KoichiShintani/FamiliesEyeDevice/Doc/FW設計.xlsx

Sheet: 機能リスト
機能一覧
 | 対象状態 | 発動条件 | 説明 | 備考
ビープ音 | 待機 | 遷移時 | 起動音 | ドミソド↑(CEGC↑)
 | 転倒 | 状態中 | 転倒音 | ドド↑ (CC↑)繰り返し 1秒毎
 | SOS | 状態中 | SOS音 | ド↑ラ (C↑A)繰り返し 20Hz
 | any | SOS押下中 | SOS SW押下 | ド↑ (C↑)(1秒毎に繰り返し)
 | 困ってる | 状態中 | 困っている状態 | ド↑ド↑ド↑ (C↑C↑C↑) の繰り返し
LED | お出かけ | 暗い判定 | 夜間照明 | 白点灯
 |  | 状態中 | 転倒時 | 紫色 10Hz
 |  | 状態中 | 困っている | 黄色 10Hz
 |  | 状態中 | SOS時 | 赤色 10Hz
 |  | 状態中 | カメラ画像取得中 | 青点灯
照度センサ | お出かけ | 状態中 | 通常状態⇔暗い状態判断
 |  |  |  | 通常→暗いの遷移条件 | 3秒以上 **lux以下
 |  |  |  | 暗い→通常の遷移条件 | 3秒以上 **lux以上
SOS SW | any |  | 押下判断
 | any |  | 3秒以上押下判断
転倒検出 | お出かけ | 状態中 | 一定の衝撃あり時
バイブレーション機能
 | お出かけ | 状態中 | 危険ポイント 遠い | 弱
 | お出かけ | 状態中 | 危険ポイント 近い | 強
 | お出かけ | 状態中 | 同様デバイス接近 | 強
BLE通信 | 詳細別紙
UART通信 | 詳細別紙

Sheet: BLE通信
1. BLE(Bluetooth Low Energy)
用途
デバイス-アプリ間の通信を行う
業務処理部との境界にインタフェースを設ける
カメラで撮影した画像以外のデータはBLEで送受信する
デバイス名 | HAKUJO_DEVICE
Services
 | Service UUID | 用途
Main | 6b15c601-e705-4470-8570-d8fef29552b2 | デバイス機能提供用
Characteristics
# | Service UUID | Characteristic UUID | Property(主要) | Descriptor | 用途 | I/O | データ形式
デバイス→アプリ
1 | 6b15c601-e705-4470-8570-d8fef29552b2 | 50ef87b6-2e1d-482e-ad7b-ef9aa8d7f7fd | READ/NOTIFY | 2902 | デバイスの転倒状態通知 | Output | 0: 正常, 1: 転倒中
2 | 6b15c601-e705-4470-8570-d8fef29552b2 | ed87309f-7835-4a92-95a0-79b74f69532c | READ/NOTIFY | 2902 | デバイスのSOS状態通知 | Output | 0: 正常, 1: SOS
アプリ→デバイス
3 | 6b15c601-e705-4470-8570-d8fef29552b2 | 5469b9c6-ac52-435d-9dd6-292cb6e95c71 | READ/WRITE | - | カメラ画像取得 | Input | 0: 開始 1:終了
4 | 6b15c601-e705-4470-8570-d8fef29552b2 | 2a2e67f7-58e6-44c3-a7fa-144979e60bcb | READ/WRITE | - | お出かけ状態 | Input | 0: 開始 1:終了
5 | 6b15c601-e705-4470-8570-d8fef29552b2 | 29a202ee-75c7-4e95-a9de-73bd7c54f60f | READ/WRITE | - | 困り状態 | Input | 0: 開始 1:終了
6 | 6b15c601-e705-4470-8570-d8fef29552b2 | d3e818a5-8317-459e-9f3d-c61617eea769 | READ/WRITE | - | 転倒 安全確認 | Input | 1: 安全を確認
7 | 6b15c601-e705-4470-8570-d8fef29552b2 | 5b271fcb-7926-40c1-be82-dbcd55572cc2 | READ/WRITE | - | 接近デバイス | Input | 0: なし 1:あり
8 | 6b15c601-e705-4470-8570-d8fef29552b2 | 29df2990-8f85-44b8-914a-7a65ad821f38 | READ/WRITE | - | 危険ポイント | Input | 0: なし 1:あり(遠い) 2:あり(近い)
9 | 6b15c601-e705-4470-8570-d8fef29552b2 | 2b6e0c77-aa69-475d-bfd8-c40a3ad9a6eb | READ/WRITE | - | 現在時刻設定 | Input | 文字列 yyyymmddhhmmss
10 | 6b15c601-e705-4470-8570-d8fef29552b2 | d4eef61a-db5e-48f6-9551-fe86b33f2965 | READ/WRITE | - | SOS状態通知 | Input | 0: 正常, 1: SOS
 |  | https://www.uuidgenerator.net/version4

Sheet: UART通信
■main基板→CAM基板への送信コマンド一覧
 | 通信コマンド(文字列) | 引数
時刻情報セット | RTC | yyyymmdd
録画開始 | REC | 1
録画終了 | REC | 0
wifi開始 | WIFI | 1
wfi終了 | WIFI | 0
■CAM基板→main基板への送信コマンド一覧
 | 通信コマンド(文字列) | 引数
肯定応答 | ACK | なし
否定応答 | NAK | なし
