KoichiShintani/FamiliesEyeDevice/Doc/HW設計.xlsx

Sheet: 部品表
部品表 |  | 個数 | 6/17注文 | 追加1
 | ESP32モジュール(main側) | 5 | 2 |  | www.amazon.co.jp/dp/B0843D6MXS
 | ESP32-DevKitC プロトタイプ基板 | 5 | 2 |  | www.amazon.co.jp/dp/B07MR6XV3S
 | ピンソケット | 1 | 1 |  | www.amazon.co.jp/dp/B012ACSZCA
 | ESP32カメラモジュール | 5 | 0 |  | https://www.csun.co.jp/SHOP/20120881201.html
 |  |  |  |  | https://akizukidenshi.com/catalog/g/gM-13200/
 | ESP32カメラモジュール | 5 | 2 |  | www.amazon.co.jp/dp/B08NP76KQN
 | 充電IC/DCDC昇圧/電池ケース | 2 | 1 |  | www.amazon.co.jp/dp/B09HCC3NWJ | 0.5A max
 | 3個セット
 | 18650リチウムイオンバッテリー | 5 | 4 |  | www.amazon.co.jp/dp/B0992G1LB9
 | ブザー | 5 | 2 |  | www.amazon.co.jp/dp/B01JRSM076 |  | 30ｍA
 | DC振動モーター | 1 |  |  | www.amazon.co.jp/dp/B089K5TW5T | はんだ面倒だからやめた
 | 5個セット
 | フォトカプラ | 5 |  |  | https://akizukidenshi.com/catalog/g/gI-11516/
 | DC振動モーター | 5 | 2 | 3 | www.amazon.co.jp/dp/B09LYB37BT |  | 90mA
 | ドライバ回路付き
 | スイッチ | 5 | 2 |  | https://amzn.to/3yhWk4F |  |  | 防水に変更
 | 10個セット
 | 加速度センサ | 5 | 2 | 3 | www.amazon.co.jp/dp/B008BOPN40
 | ブレッドボード | 5 | 2 |  | www.amazon.co.jp/dp/B00DSKCS68
 | ブレッドボードジャンパー線 | 1 | 1 |  | www.amazon.co.jp/dp/B09BYNQYKT
 | はんだごて | 1 | 1 |  | www.amazon.co.jp/dp/B09Q7R32BG
 | はんだ | 1 | 1 |  | www.amazon.co.jp/dp/B001PR1L32
 | 線材 | 1 | 1 |  | www.amazon.co.jp/dp/B07GGZQXSF
 | ワイヤーストリッパー | 1 | 1 |  | www.amazon.co.jp/dp/B000CED24U
 | デジタルオシロ | 1 | 1 |  | www.amazon.co.jp/dp/B077D3XWHX
 | はんだ吸い取り線 | 1 | 1 |  | www.amazon.co.jp/dp/B07N2TJDM8
 | こて台 | 1 | 1 |  | www.amazon.co.jp/dp/B017SQ0TUO
 | デジタルテスター | 1 | 1 |  | www.amazon.co.jp/dp/B07GJ891VR
 | 収縮チューブ | 1 | 1 |  | www.amazon.co.jp/dp/B07Z2WF1CS
 | 照度センサ | 5 | 2 |  | https://akizukidenshi.com/catalog/g/gI-05859/
 | フルカラーLED | 5 | 2 |  | https://akizukidenshi.com/catalog/g/gK-14256/ |  | 60mA
 | フルカラーLED | 3 | 3 |  | https://akizukidenshi.com/catalog/g/gI-02547/ |  | 高輝度LED(アノードコモンに変更)
 | ロジック変換IC 5V⇔3.3V | 1 | 1 |  | www.amazon.co.jp/dp/B07RJL759J |  | ロジック変換不要回路に変更
 | 5V→3.3V降圧電源 | 1 | 1 |  | www.amazon.co.jp/dp/B086WWGVCL |  | ESP32基盤にあるので不要
 | ロッカースイッチ | 1 | 1 |  | www.amazon.co.jp/dp/B09KBRBFH9 |  | 防水に変更
 | 基盤スペーサー | 1 | 1 |  | www.amazon.co.jp/dp/B099FJCB1T
 | 防水プッシュボタン | 2 | 1 |  | www.amazon.co.jp/dp/B08LKMB448
 | 防水ロッカースイッチ | 1 | 1 |  | www.amazon.co.jp/dp/B098NLSJXS
 | 3線コネクタ | 1 | 1 |  | www.amazon.co.jp/dp/B07ZZ8PQKZ

Sheet: ESP32devkitピンアウト
初期値

Sheet: ラズパイ０構成(検討中)
 |  | 6/26注文
カメラ | 2 | 2 | https://www.amazon.co.jp/gp/product/B07DD67T4P/ref=ox_sc_act_image_4?smid=A38ZRZCGYBKPQ1&psc=1
ラズパイzero | 2 | 2 | https://www.switch-science.com/catalog/3646/
UPS | 2 | 2 | https://www.amazon.co.jp/gp/product/B08D678XPR/ref=ox_sc_act_image_5?smid=A2XJCI95TIXSZX&psc=1
USBミニジャック | 2 | 2 | https://www.amazon.co.jp/gp/product/B08X6K42CR/ref=ox_sc_act_image_1?smid=A3NRSC7QUIYENX&psc=1
ミニジャックマイク | 2 | 2 | https://www.amazon.co.jp/gp/product/B08X6K42CR/ref=ox_sc_act_image_1?smid=A3NRSC7QUIYENX&psc=1
ミニジャックスピーカー | 2 | 2 | https://www.amazon.co.jp/gp/product/B071JF3QZK/ref=ox_sc_act_image_1?smid=A1D0T287JKKBZE&psc=1

Sheet: kicadメモ
①シンボルエディターで、シンボルを作成する
 | 世の中にあるライブラリは取り込むだけ。
 | 新規ライブラリフォルダを作成して、シンボルを追加or新規作成していく。
 | 👆みたいにライブラリに取り込む。フットプリントも一緒に落ちてるケースもあり。
 | https://marunaka-blog.com/kicad-parts-library-add/1453/
 | https://www.rs-online.com/designspark/pcb-part-library--kicad
無ければ自分で作る。
 | https://spiceman.jp/kicad-creating-symbol/
②フットプリントエディタでフットプリントも作成する。
 | 新規ライブラリ作成して、その場所で新規作成する。ウィザードから作成すると楽。
 | ※似たやつからちょっとカスタムするとらくちん
③回路図エディタで回路図を作成する。
 | シンボルエディタで作成したシンボルを取り込んで配置、配線していく。
 | 基本的なパーツはデフォであるが、フットプリントが関連づいてないやつもあるので注意。
④PCBエディタで、基板のデザインを行う。
 | シンボルと、フットプリントが関連づいてないやつがあると、生成できないので関連付けしてあげる。
 | https://spiceman.jp/kicad-pcbnew-layout/
④回路図作成したら、ファイルの製造用ファイルを作成する。
 | ガーバーファイルと、ドリルファイルが必要。
 | https://cinnamon-kuroneko.net/fusionpcb-kicad/
 | https://www.fusionpcb.jp/fusion_pcb.html
