KoichiShintani/FamiliesEyeDevice/Doc/Kicad/main_borad/test/test.kicad_pcb

## KiCad design Doc/Kicad/main_borad/test/test.kicad_pcb (2022-08-10)

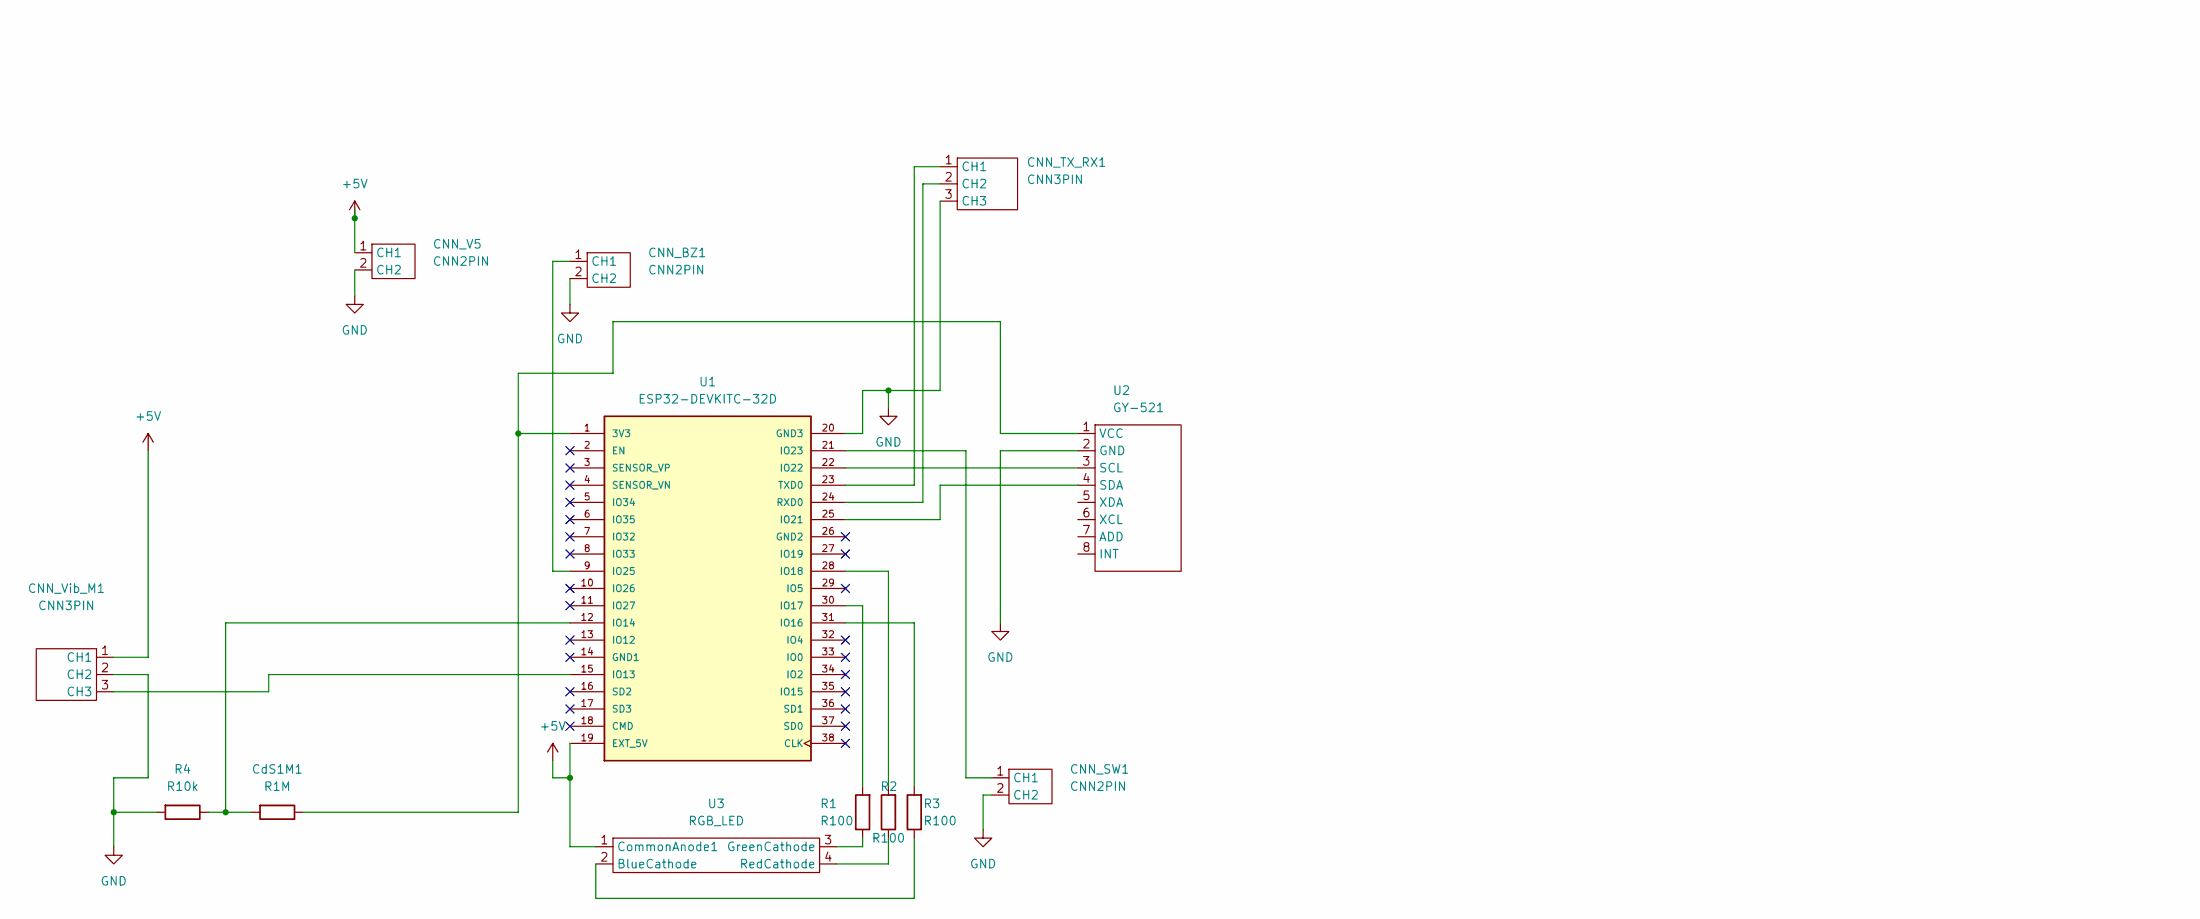
[picture p1: schematic test.kicad_sch]

Parts:
CNN_BZ1: CNN2PIN; SIP-2
CNN_SW1: CNN2PIN; SIP-2
CNN_TX_RX1: CNN3PIN; SIP-3
CNN_V5: CNN2PIN; SIP-2
CNN_Vib_M1: CNN3PIN; SIP-3
CdS1M1: R1M; SIP-2
R1, R2, R3: R100; SIP-2
R4: R10k; SIP-2
U1: ESP32-DEVKITC-32D; MODULE_ESP32-DEVKITC-32D; PARTREV 4
U2: GY-521; SIP-8
U3: RGB_LED; DIP-4_200_ELL

Connections:
+5V: CNN_V5.1 (CH1), CNN_Vib_M1.1 (CH1), U1.19 (EXT_5V), U3.1 (CommonAnode1)
GND: CNN_BZ1.2 (CH2), CNN_SW1.2 (CH2), CNN_TX_RX1.3 (CH3), CNN_V5.2 (CH2), CNN_Vib_M1.2 (CH2), R4.2, U1.20 (GND3), U2.2 (GND)
unnamed: CNN_TX_RX1.1 (CH1), U1.23 (TXD0)
unnamed: CNN_TX_RX1.2 (CH2), U1.24 (RXD0)
unnamed: CdS1M1.1, U1.1 (3V3), U2.1 (VCC)
unnamed: R1.2, U1.30 (IO17)
unnamed: R2.2, U1.28 (IO18)
unnamed: R3.2, U1.31 (IO16)
unnamed: CNN_BZ1.1 (CH1), U1.9 (IO25)
unnamed: CdS1M1.2, R4.1, U1.12 (IO14)
unnamed: CNN_Vib_M1.3 (CH3), U1.15 (IO13)
unnamed: CNN_SW1.1 (CH1), U1.21 (IO23)
unnamed: U1.22 (IO22), U2.3 (SCL)
unnamed: U1.25 (IO21), U2.4 (SDA)
unnamed: R3.1, U3.2 (BlueCathode)
unnamed: R1.1, U3.3 (GreenCathode)
unnamed: R2.1, U3.4 (RedCathode)

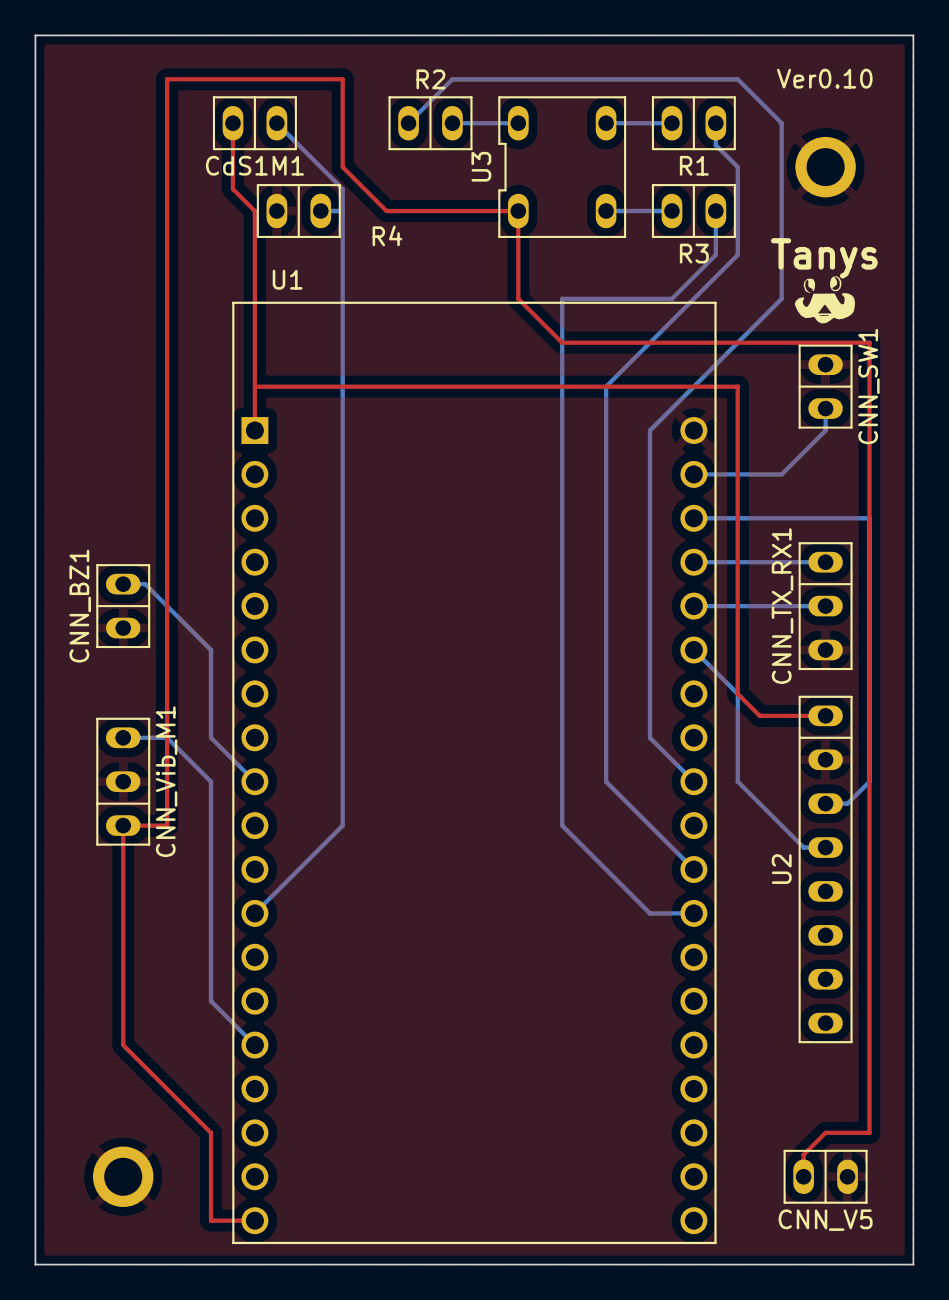
[picture p2: board test.kicad_pcb from above]

Board: 2 copper layers, 50.8 x 71.1 mm, 13 parts (0 on the bottom side), 17 nets.
